sullyjason/CRAEFT-Controller/STL_files/README.md

# CRAEFT 3D printing files
- Printed with an FDM printer
- Recommended materials: PLA, Tough PLA, PETG
