sullyjason/CRAEFT-Controller/PCB/README.md

# CRAEFT Controller PCB
- Designed with KiCAD 8.0
- This is a corrected version of the PCB in the original controller
