sullyjason/CRAEFT-Controller/Images/Final/IMG_0231 2.jpeg

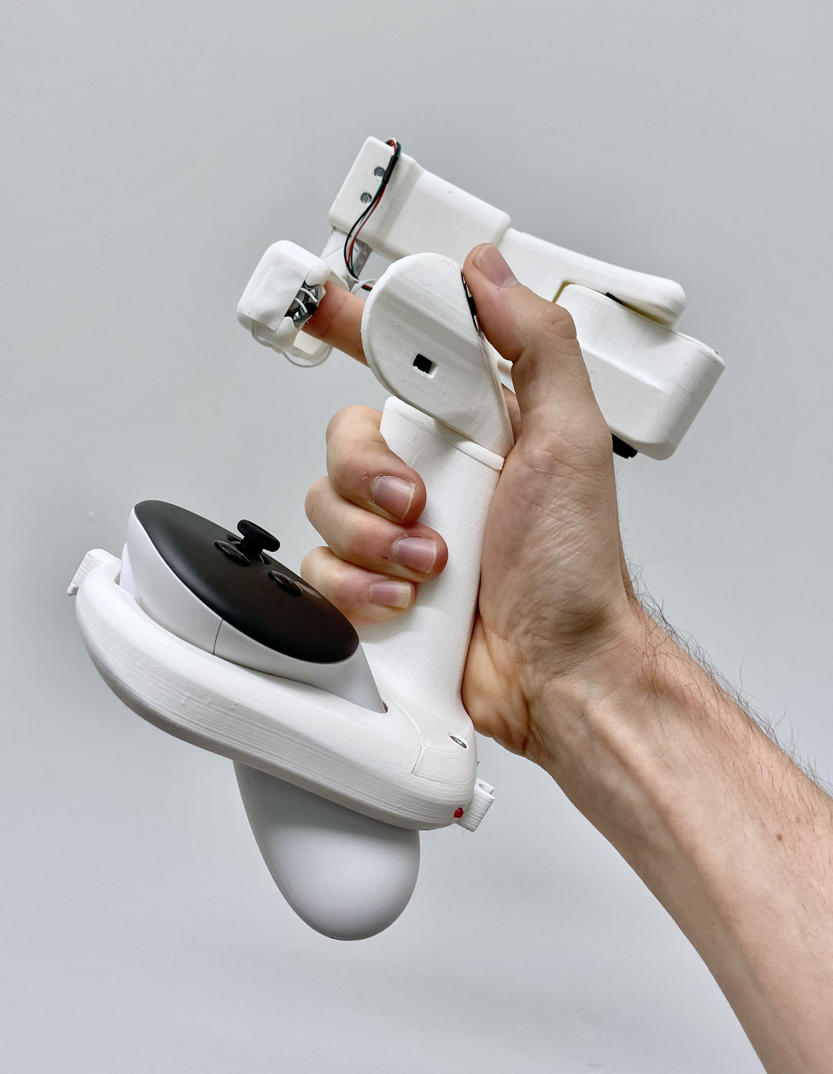
Images/Final/IMG_0231 2.jpeg
