sullyjason/CRAEFT-Controller/Images/Final/IMG_0232 2.jpeg

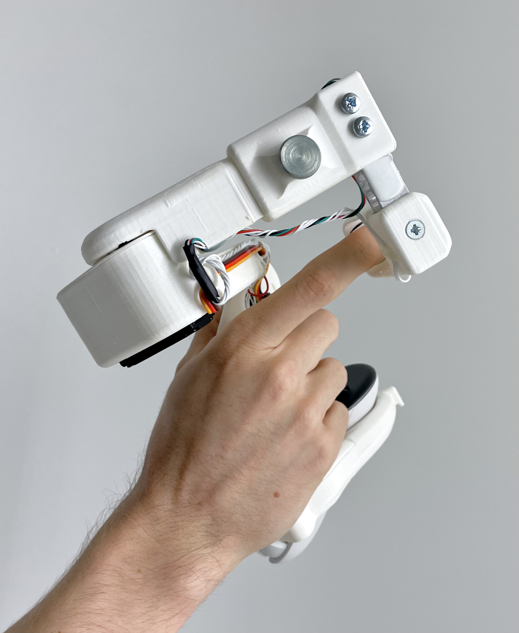
Images/Final/IMG_0232 2.jpeg
