sullyjason/CRAEFT-Controller/Images/Final/IMG_0303.jpeg

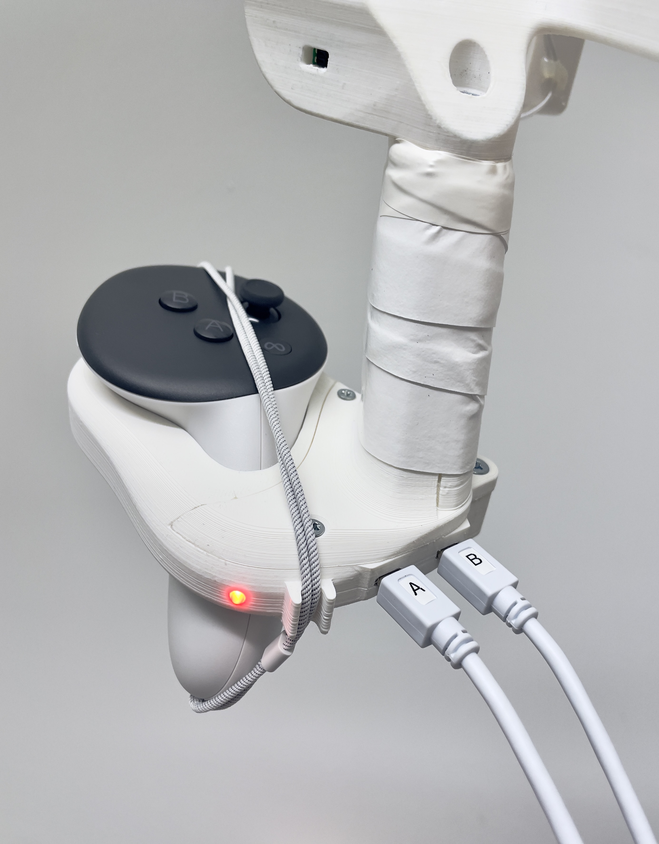
Images/Final/IMG_0303.jpeg
