sullyjason/CRAEFT-Controller/Images/Final/IMG_0320.jpeg

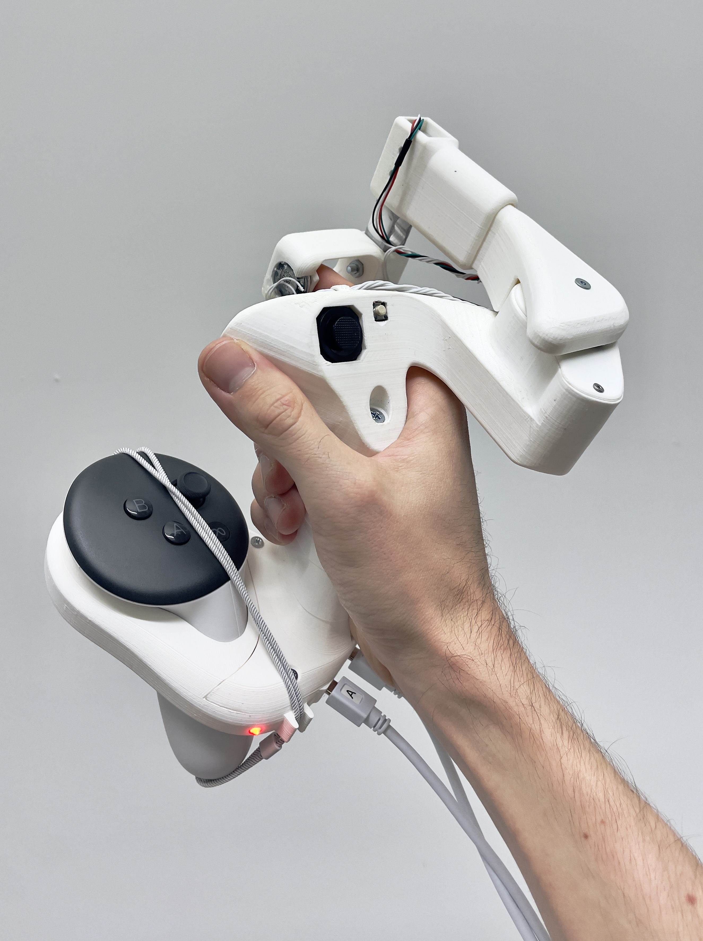
Images/Final/IMG_0320.jpeg
