sullyjason/CRAEFT-Controller/Images/Final/IMG_0330.jpeg

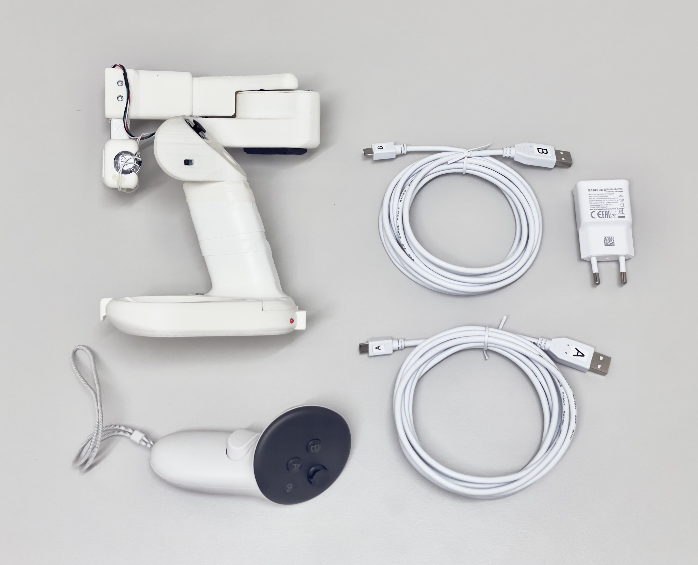
Images/Final/IMG_0330.jpeg
