sullyjason/CRAEFT-Controller/Images/Process/IMG_0164.jpeg

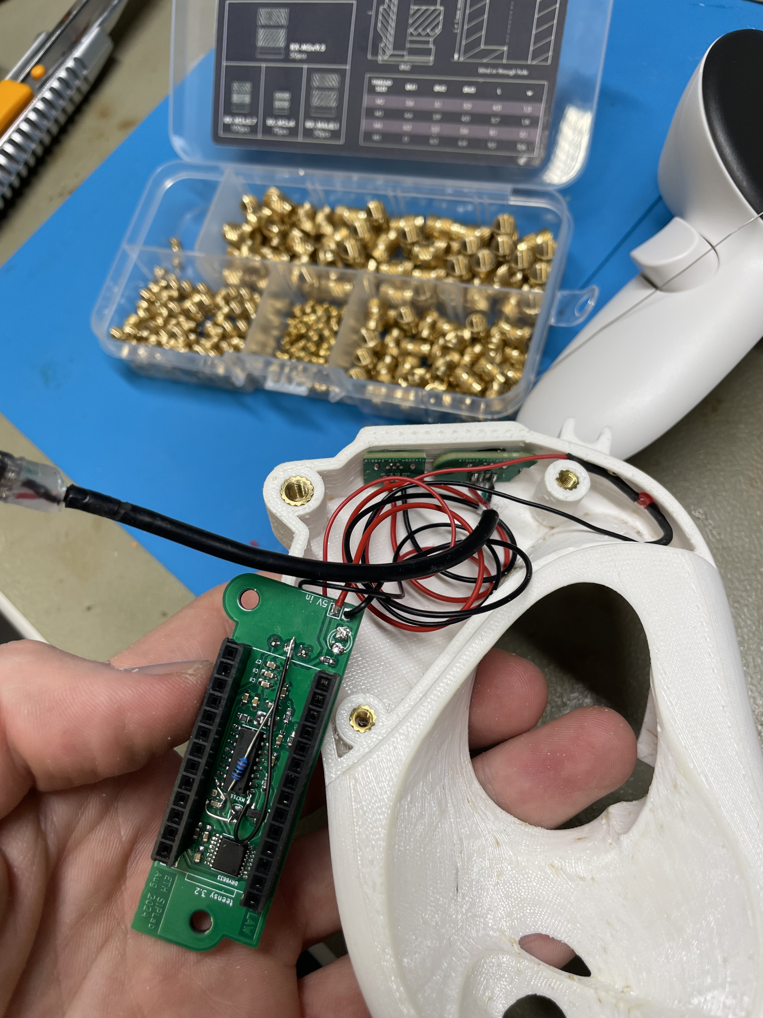
Images/Process/IMG_0164.jpeg
