sullyjason/CRAEFT-Controller/Images/Process/IMG_0166.jpeg

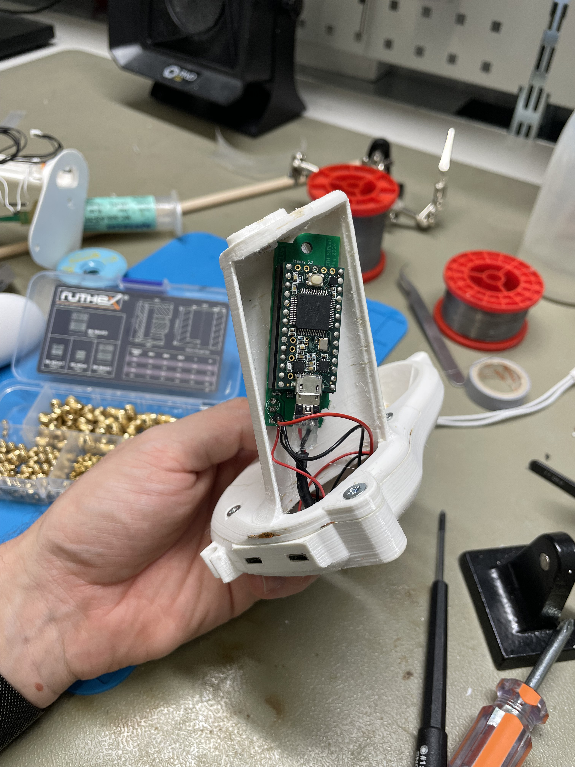
Images/Process/IMG_0166.jpeg
