sullyjason/CRAEFT-Controller/Images/Process/IMG_0172.jpeg

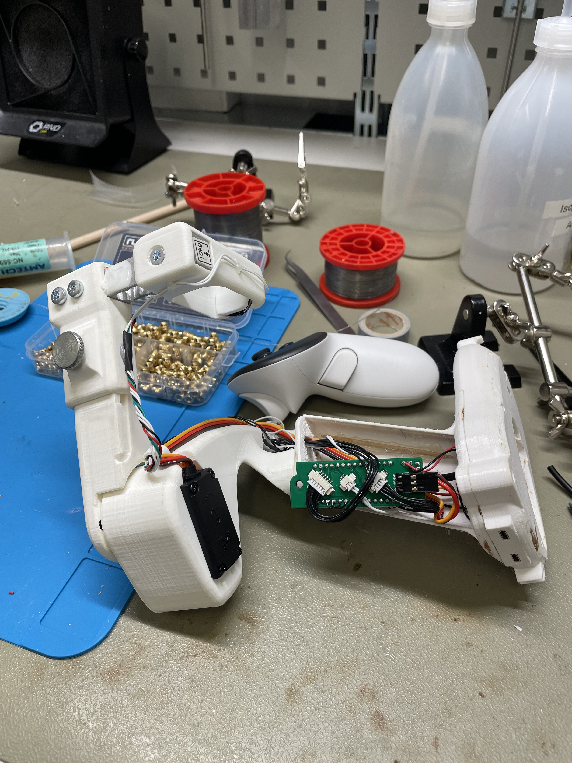
Images/Process/IMG_0172.jpeg
