sullyjason/CRAEFT-Controller/Images/Process/IMG_0183.jpeg

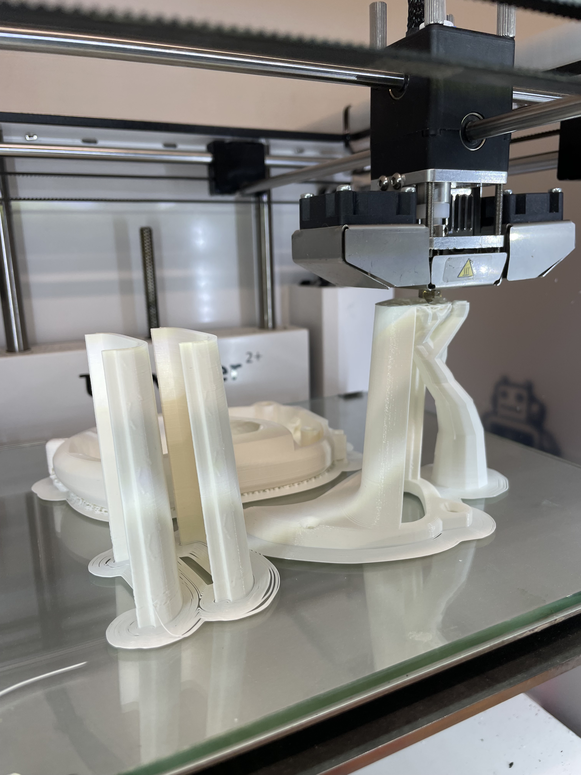
Images/Process/IMG_0183.jpeg
