sullyjason/CRAEFT-Controller/Images/Process/IMG_0200.jpeg

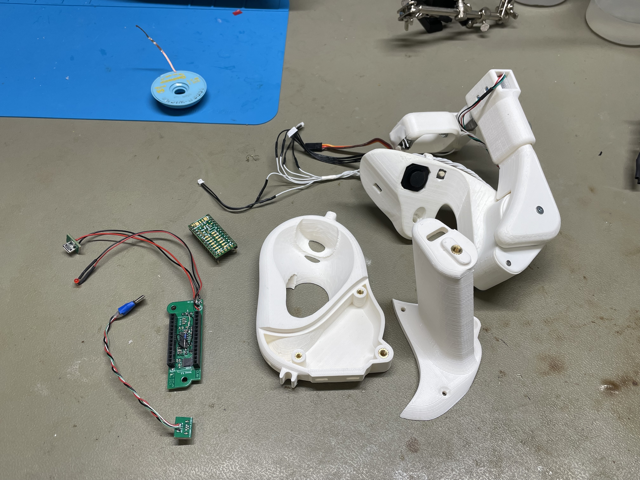
Images/Process/IMG_0200.jpeg
