sullyjason/CRAEFT-Controller/Images/Process/Screenshot 2024-08-07 at 23.27.53.png

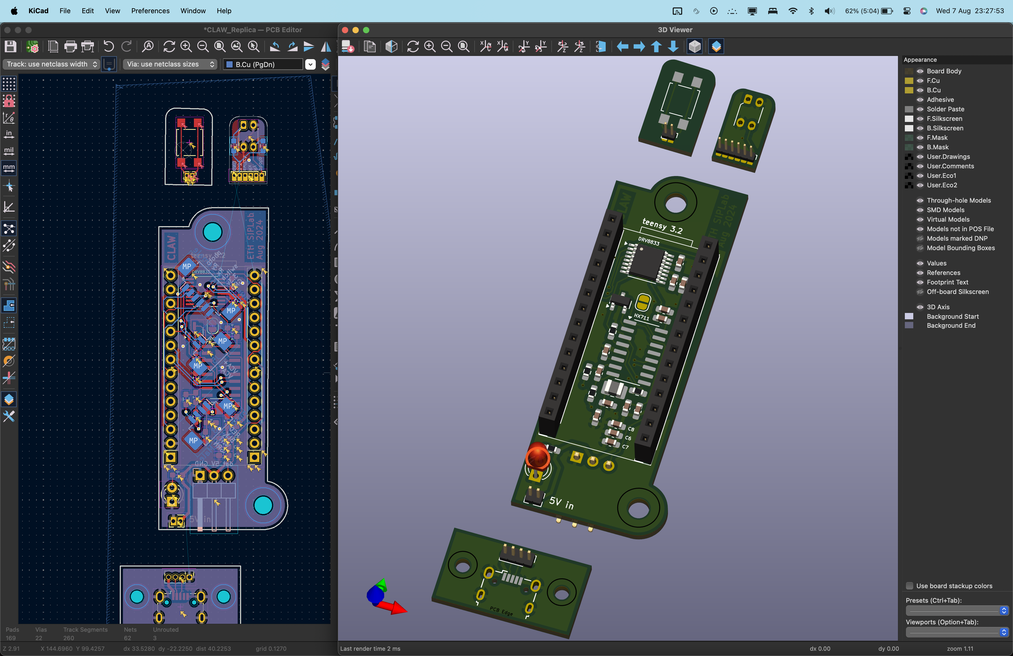
Images/Process/Screenshot 2024-08-07 at 23.27.53.png
