sullyjason/CRAEFT-Controller/Images/Prototyping/version 1.1/IMG_9729.jpeg

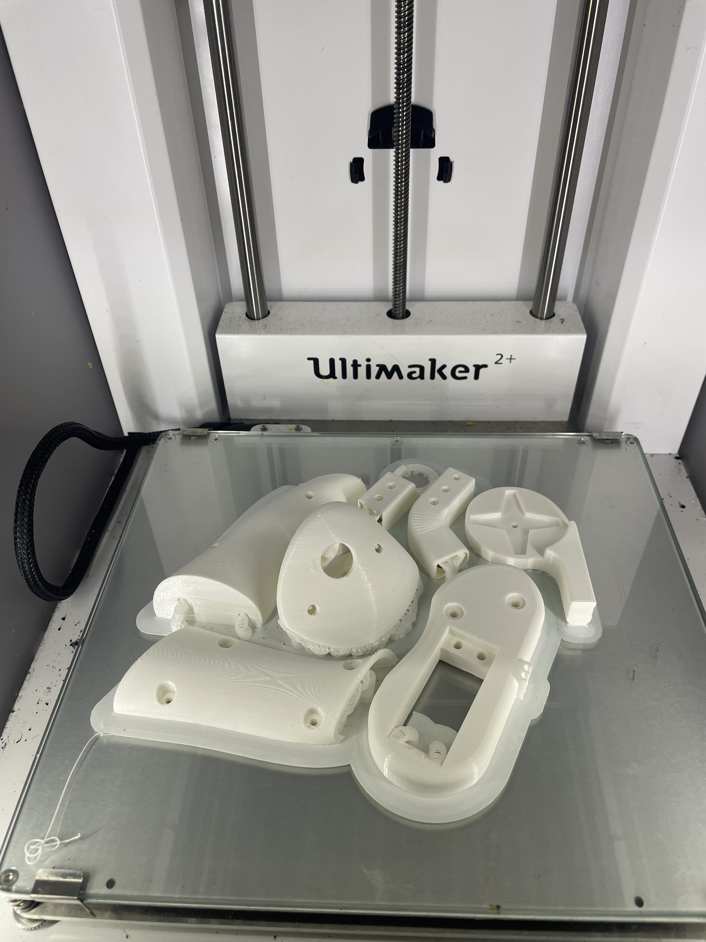
Images/Prototyping/version 1.1/IMG_9729.jpeg
