sullyjason/CRAEFT-Controller/Images/Prototyping/version 1.1/Screenshot 2024-08-06 at 01.14.45.png

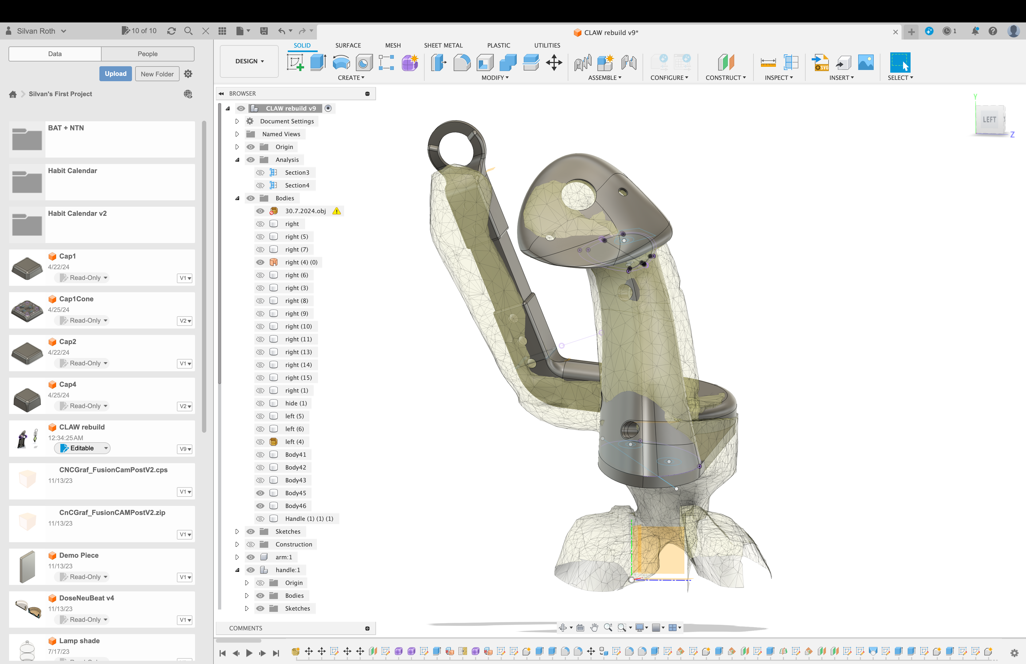
Images/Prototyping/version 1.1/Screenshot 2024-08-06 at 01.14.45.png
