sullyjason/CRAEFT-Controller/PCB/Print Schematic.pdf

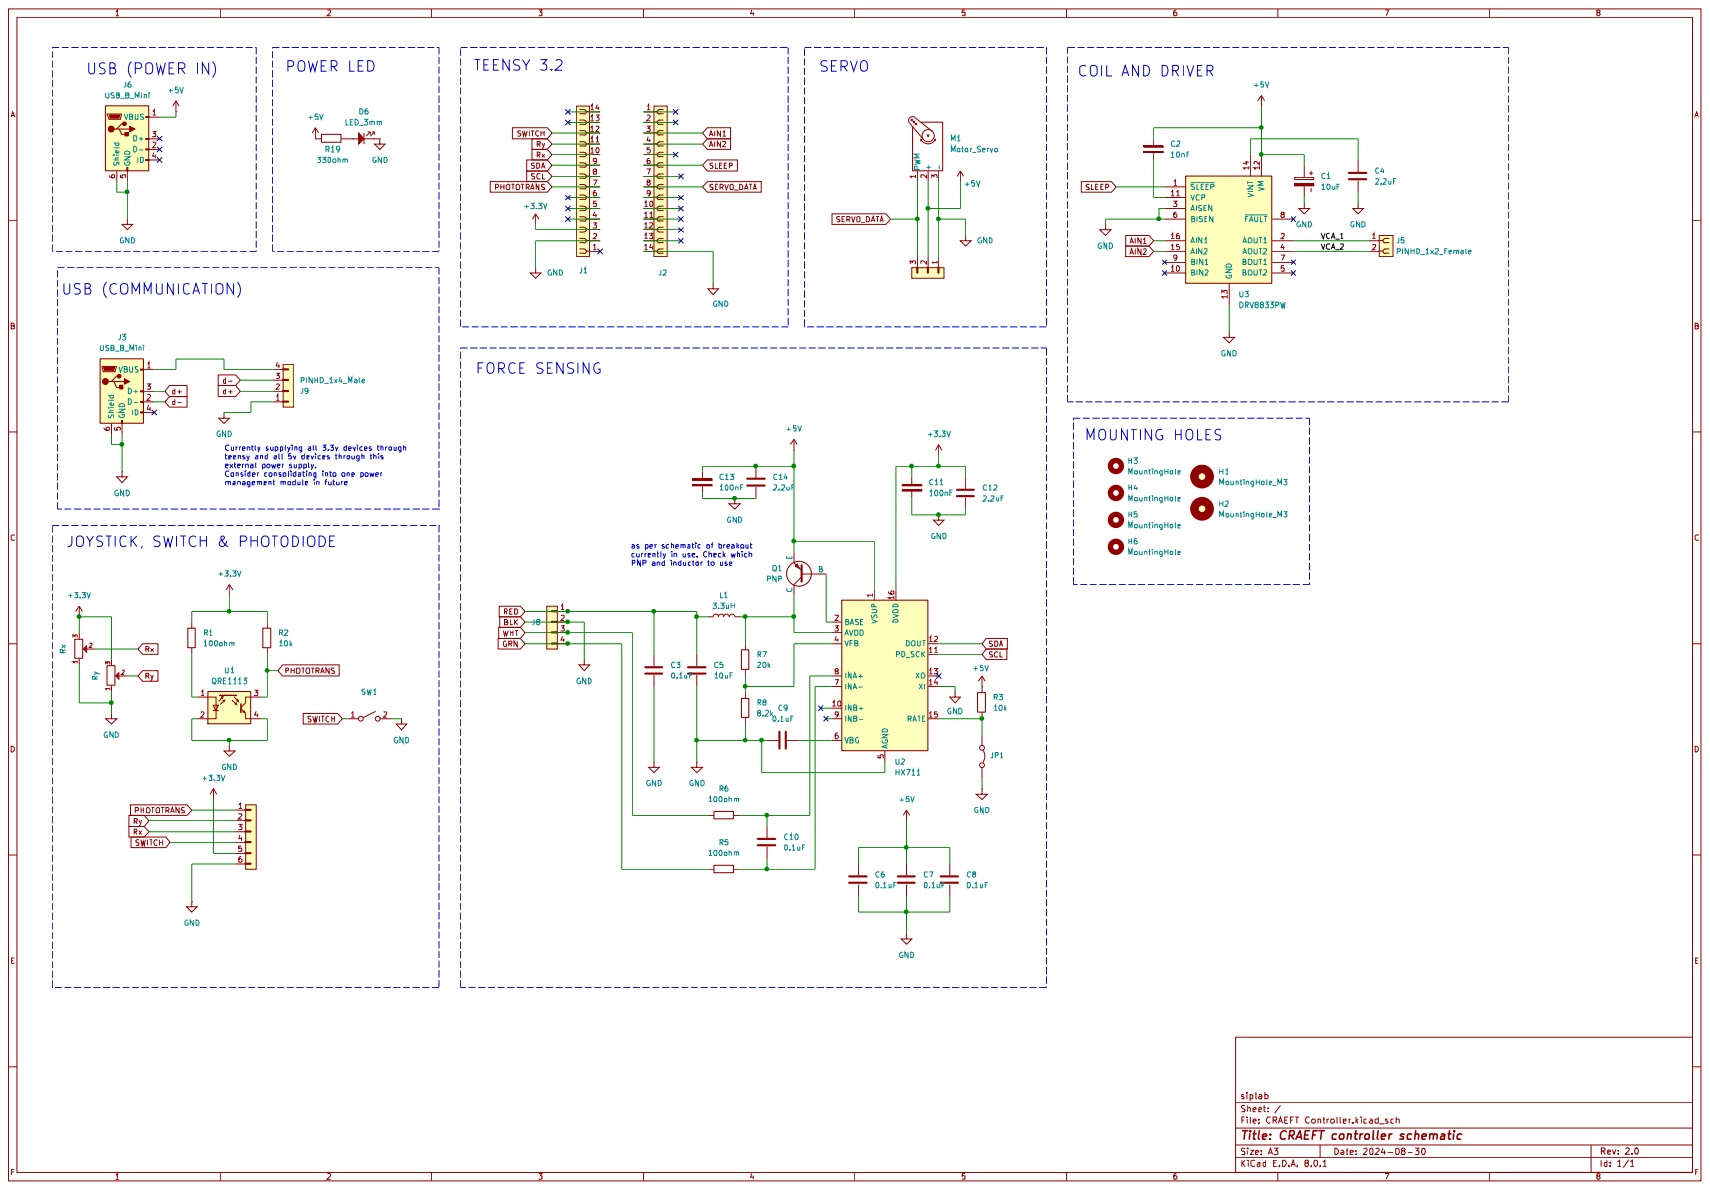
[picture p22: page 1]
