sullyjason/CRAEFT-Controller/(commit log)

2024-09-11 Create Servo_and_VCA_Test_Code
2024-09-11 Create CLAW_Controller_Embedded_Original
2024-09-13 add pid loop draft
2024-09-14 flip servo angle rotations
    [CRAEFT_controller_fw.ino]
2024-09-17 added stls, pcb files, updated photos and readme
2024-09-21 added photos and diagrams, updated readme
    [BOM.csv]
