sullyjason/CRAEFT-Controller/Images/Process/IMG_9852.jpeg

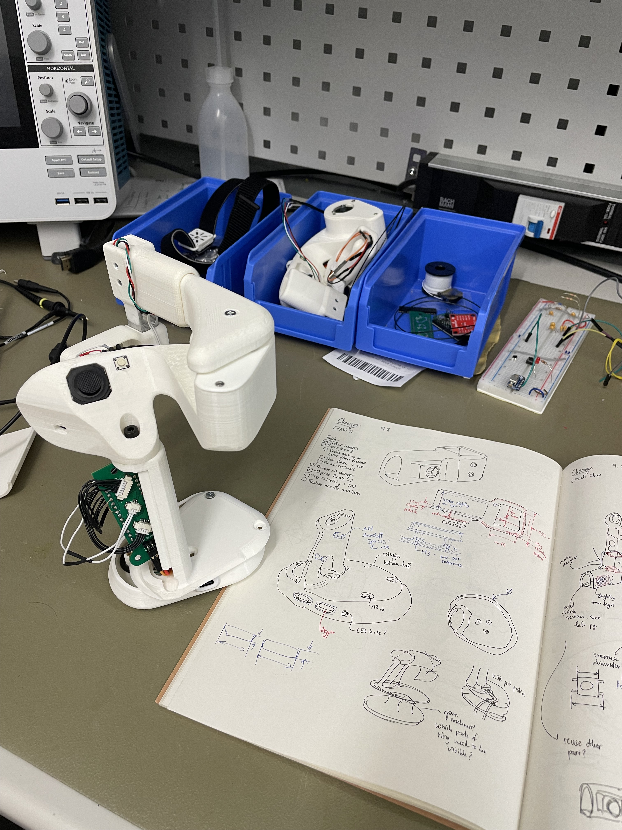
Images/Process/IMG_9852.jpeg
