sullyjason/CRAEFT-Controller/Images/Prototyping/version 1.1/IMG_9731.jpeg

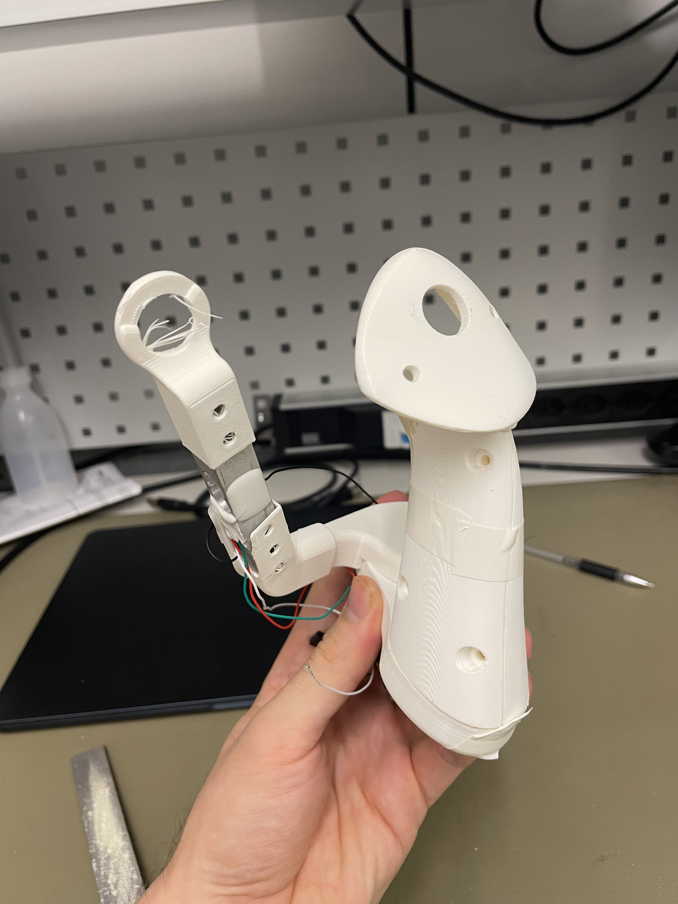
Images/Prototyping/version 1.1/IMG_9731.jpeg
